CL-32/CL-32/CL32_296x120.bmp

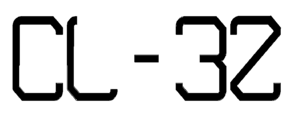
CL32_296x120.bmp
