CL-32/CL-32/Add-on/CL-32-LED/CL-32-LED.step

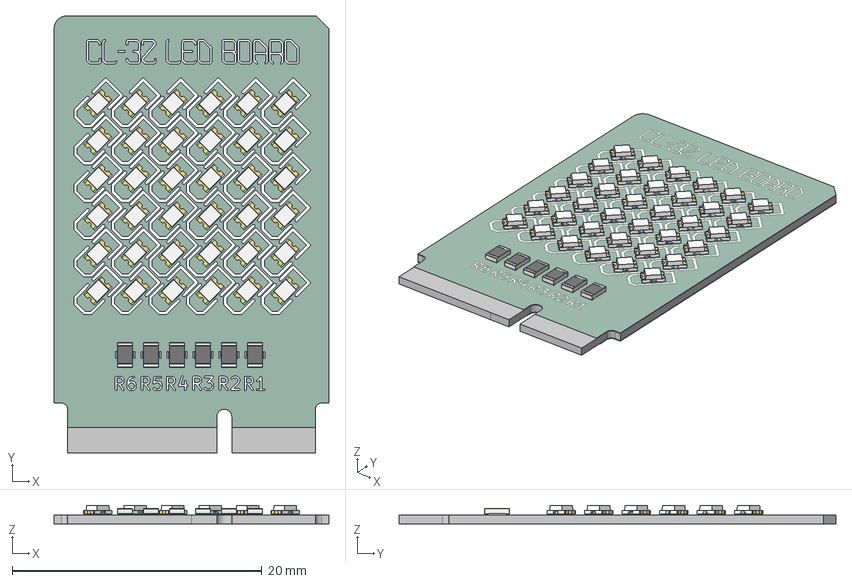
[picture p2: CAD file, 2025-10-23]
Add-on/CL-32-LED/CL-32-LED.step
22.0 x 35.0 x 1.55 mm
LED-SMD_L2.0-W1.3-H0.8 x 36
R_0805_2012Metric x 6
CL-32-LED_silkscreen
CL-32-LED_soldermask x 2
CL-32-LED_PCB
