CL-32/CL-32/PCB/Base Schematic.pdf

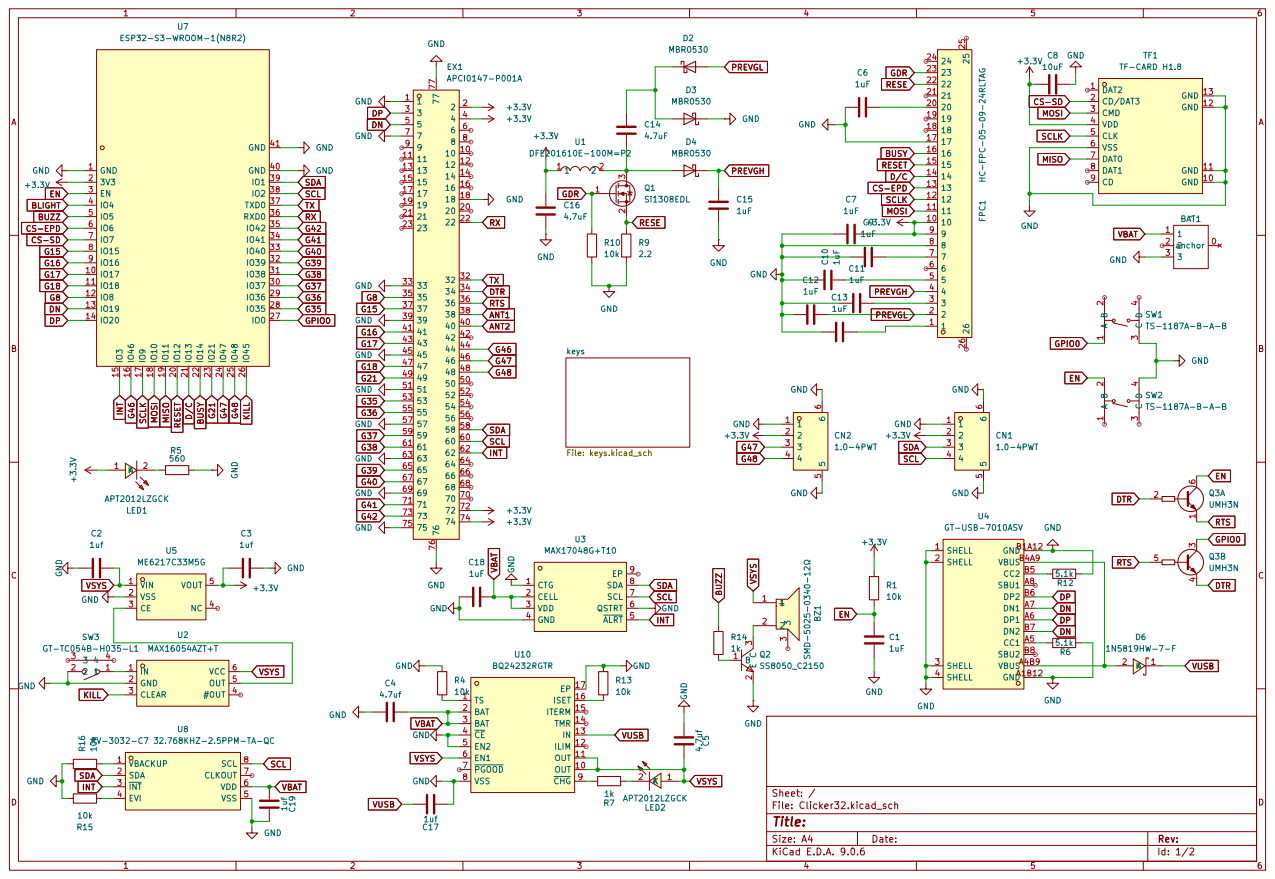
[picture p3: page 1]

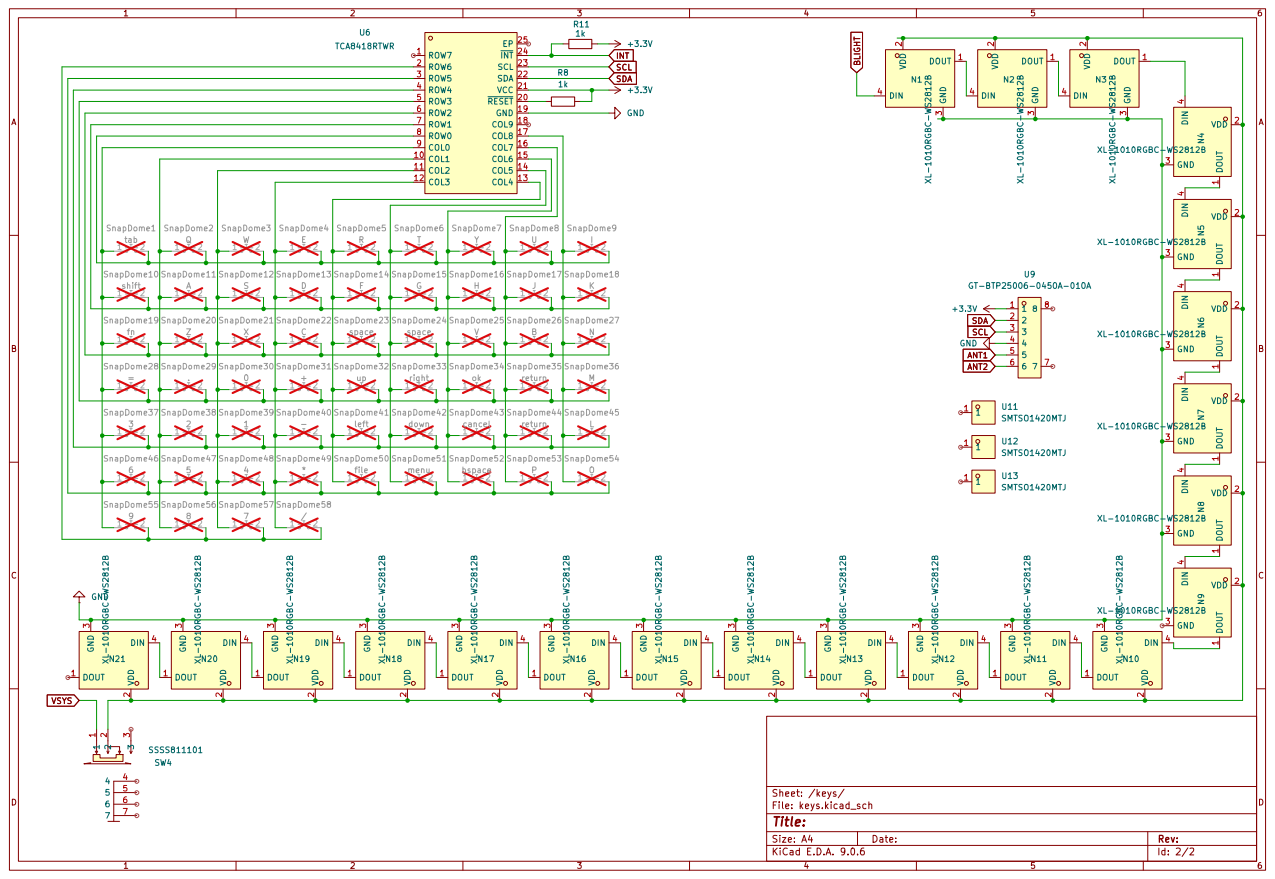
[picture p4: page 2]
