CL-32/CL-32/Add-on/CL-32-Cam/schematic.pdf

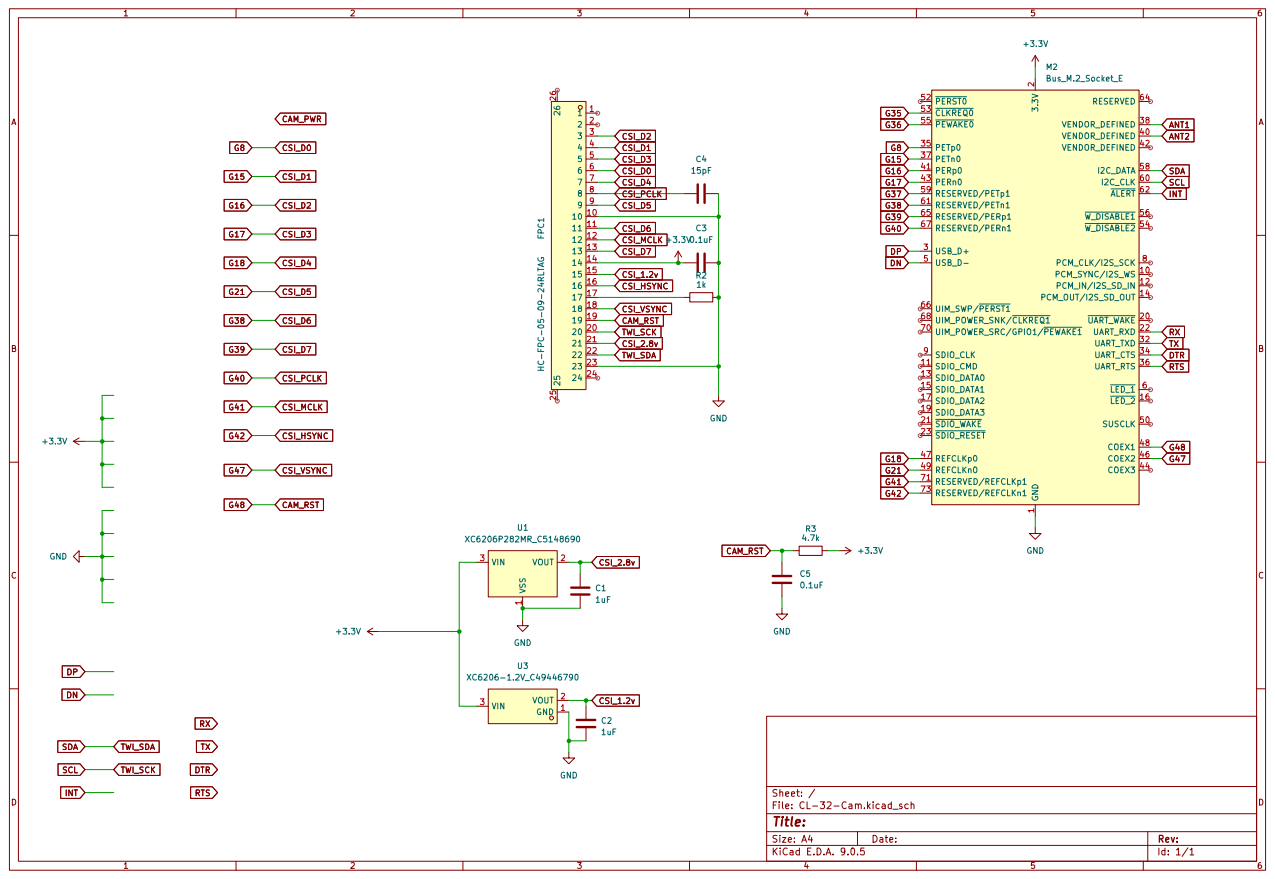
[picture p5: page 1]
