CL-32/CL-32/Add-on/CL-32-LED/schematic.pdf

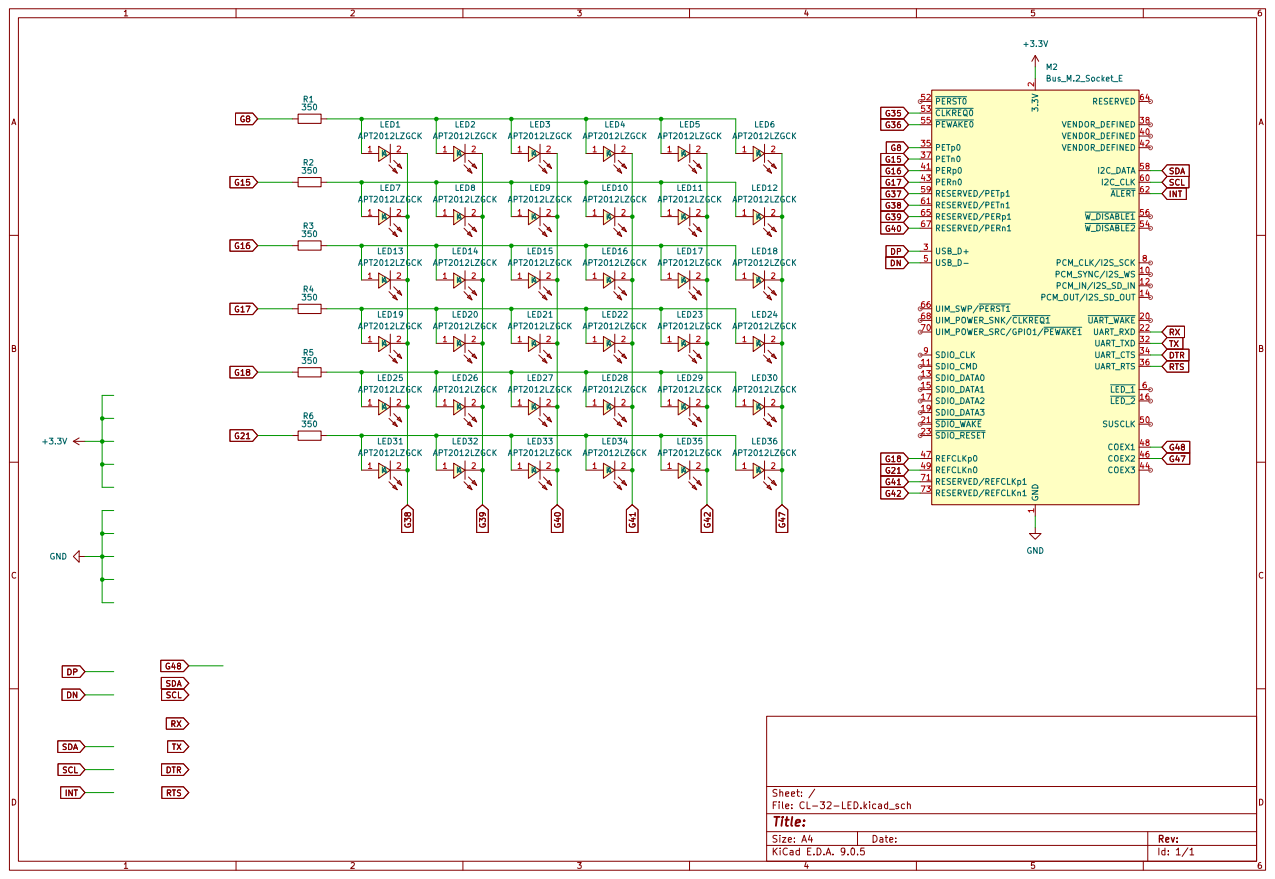
[picture p6: page 1]
