CL-32/CL-32/Add-on/CL-32-Mesh/schematic.pdf

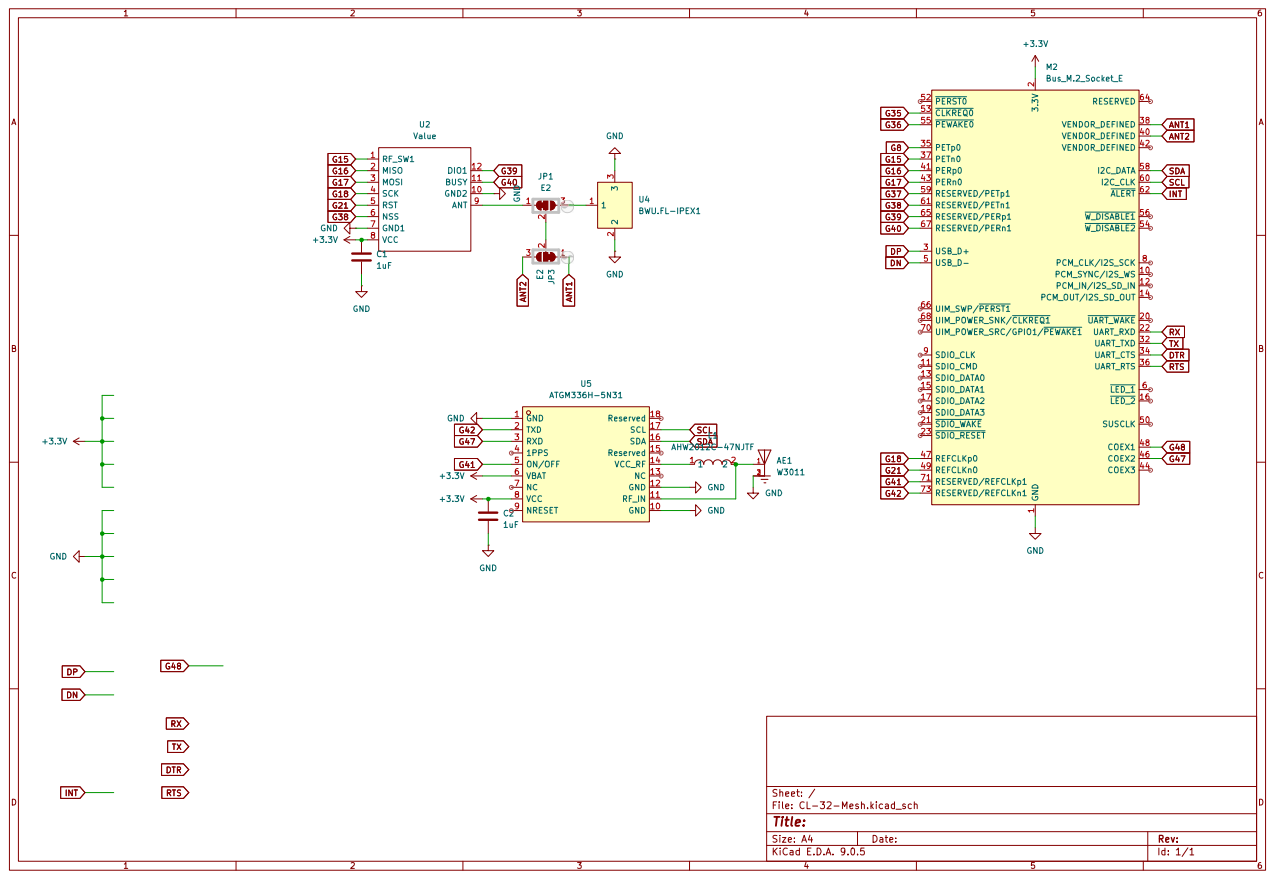
[picture p7: page 1]
