CL-32/CL-32/Software/CL-32/src/main.cpp

#include <Arduino.h>
#include "CL32.h"

int refreshCount;
volatile bool i2c_int = false;

void IRAM_ATTR letsGo(){
  i2c_int = true;
}

void setInterrupt(){
  //reset the correct interrupt after we have woken from sleep
  if(!blockSleep&&doSleep&&!_CL32.getUSB()){
    detachInterrupt(CL32_int);
    if (esp_sleep_enable_ext0_wakeup(GPIO_NUM_3, 0) != ESP_OK) {
        _screen.showMsg("GPIO interrupt failed");
    }
    if(refreshCount==0||(saverTime>0 && refreshCount>=saverTime)){//re-enable the timer
      if ( esp_sleep_enable_timer_wakeup(60000000) != ESP_OK) {
          _screen.showMsg("TIMER interrupt failed");
      }
    }
  }
  else {
    i2c_int = false;
    esp_sleep_disable_wakeup_source(ESP_SLEEP_WAKEUP_ALL);
    attachInterrupt(CL32_int ,letsGo, FALLING );
  }
}

void setup() {
    _screen.init();
    _CL32.init();
    _time.init();
    _CL32.add_callback(menu_keys);
    //Serial.begin(115200);
    draw_menu(fastAppSwitch);
    refreshCount = 0;
    doSleep=false;//force this false to get the start to be without sleep
    setInterrupt();
    load_set();//load the settings to probably put the sleep back
}

void loop() {
  if(i2c_int || esp_sleep_get_wakeup_cause()==ESP_SLEEP_WAKEUP_EXT0){
    //the interrupt is shared, so we need to see who is shouting
    _CL32.read();
    _time.read();
    refreshCount = 0;
    if(i2c_int) i2c_int = false;
    setInterrupt();
    if(!blockSleep&&doSleep&&!_CL32.getUSB()){
      esp_light_sleep_start();
    } 
  }
  else if(esp_sleep_get_wakeup_cause()==ESP_SLEEP_WAKEUP_TIMER){
    refreshCount++;
    if(saverTime>0 && refreshCount>=saverTime){
      _screen.drawSleep();
      esp_sleep_disable_wakeup_source(ESP_SLEEP_WAKEUP_TIMER);//stop the wakey wakey
    }
    else{
      _screen.refreshStatus();
    }
    esp_light_sleep_start(); //no need to check the variable here, this will only happen on timer wake which wont happen if sleep never happens
  }
}
