CL-32/CL-32/Software/CL-32/src/menu.cpp

#include <Arduino.h> 
#include "CL32.h"
//enum AppList {EDIT,CALC,TODO,CAL,AUTH,READ,SET};    
void change_app(bool increment){
    if(increment){
        switch (newApp) {
            case EDIT: newApp =  CALC; break;
            case CALC: newApp = TODO; break;
            case TODO: newApp =  CAL; break;
            case CAL: newApp =  AUTH; break;
            case AUTH: newApp =  READ; break;
            case READ: newApp =  SET; break;
            case SET: newApp = POWER; break;
            case POWER: newApp = EDIT;
        }
    }
    else{
        switch (newApp) {
            case EDIT: newApp =  POWER; break;
            case POWER: newApp =  SET; break;
            case CALC: newApp = EDIT; break;
            case TODO: newApp =  CALC; break;
            case CAL: newApp =  TODO; break;
            case AUTH: newApp =  CAL; break;
            case READ: newApp =  AUTH; break;
            case SET: newApp = READ;
        }
    }
}

//callback function for deciding what the menu does with the keyboard evenrs
void menu_keys(){
    for(byte i = _CL32.eventCount();i>0;i--){
        Event eTemp = _CL32.getKey();
        if(eTemp.keyDown){
            if(!eTemp.isChar){
                if(eTemp.keyData==KB_DOWN){
                    change_app(true);
                }
                else if(eTemp.keyData==KB_UP){
                    change_app(false);
                }
                else if(eTemp.keyData==KB_RET){
                    currentApp = newApp;
                    isMenu = OFF;//take it out of menu mode
                }
                else if(eTemp.keyData==KB_TAB){
                }
            }
            //dont really need an else here, if its not the 3 char's we aee interested in, then we dont neeed that key
        }
    }
    if(isMenu==OFF){        
        if(currentApp==EDIT){
            _CL32.add_callback(editor_keys);
            draw_editor(fastAppSwitch);
        }
        else if(currentApp==CALC){
            _CL32.add_callback(calc_keys);
            draw_calc(fastAppSwitch);
        }
        else if(currentApp==TODO){
            _CL32.add_callback(todo_keys);
            draw_todo(fastAppSwitch);
        }
        else if(currentApp==CAL){
            _CL32.add_callback(cal_keys);
            draw_cal(fastAppSwitch);
        }
        else if(currentApp==AUTH){
            _CL32.add_callback(twofa_keys);
            draw_twofa(fastAppSwitch);
        }
        else if(currentApp==READ){
            _CL32.add_callback(reader_keys);
            draw_reader(fastAppSwitch);
        }
        else if(currentApp==SET){
            _CL32.add_callback(set_keys);
            draw_set(fastAppSwitch);
        }
        else if(currentApp==POWER){
            _screen.clearScreen(false,true);
            _screen.showMsg("Powered Off");
            _CL32.shutdown();
        }
    }
    else{
        draw_menu(true);
    }
} 

//function for drawing the menu
void draw_menu(bool goFast){
    _screen.clearScreen(false,goFast);
    _screen.addHead("Menu");
    byte listOffset;
    if(newApp < 4){
        listOffset = 0;
    }
    else if(newApp > 4){
        listOffset = 1;
    }
    else{
        listOffset = newApp - 3;
    }
    for(byte i = 0;i<7;i++){
        if(i+listOffset==newApp){
            _screen.setFont(12,true,false);
        }
        else{
            _screen.setFont(12,false,false);
        }
        _screen.addText(appNames[i+listOffset],20,40+(i*20),true);
    }
    _screen.show(goFast);
}
