CL-32/CL-32/Software/CL-32/src/2fa.cpp

#include "CL32.h"
#include <Arduino.h> 


//callback function for deciding what to do with keyboard events
void twofa_keys(){
    for(byte i = _CL32.eventCount();i>0;i--){
        Event eTemp = _CL32.getKey();
        if(eTemp.keyDown){
            if(!eTemp.isChar){

            }
            else{

            }
        }
    }
    if(isMenu==ON){
        _CL32.add_callback(menu_keys);
        draw_menu(fastAppSwitch);
    }
    else{
        draw_twofa(true);
    }


}
//function for drawing the file browser screen
void draw_twofa(bool goFast){
    _screen.clearScreen(false,goFast);
    _screen.addHead("2FA Auth");

    //draw some stuff
    
    _screen.show(goFast);

}
