CL-32/CL-32/(commit log)

2025-10-14 refresh PCB
    removed EEPROM from the blank PCB, added back PCB incase anyone wants a play
2025-10-23 mesh board and LED board
    started populating the add-on boards so people can make their own
    [CL-32-LED.step]
2025-10-25 camera board
    camera board should be ready to play with
2025-11-22 more polish
    now does fast refresh between sections, menu button on the device now opens a sub menu (only in editor for now) there you can open a file, but the editor needs keyboard mapping
2025-11-23 file browser fix
    fixed some of the issues listing files, added some navigation on the editor
    [browser.cpp, editor.cpp]
2025-11-24 more tweakin
    got the battery monitoring involved, and some tweaks on editor navigation and editing
2025-11-25 more polishing
    added interupt read for RTC, and the space is there for the fuel gauge ic so you can clear any stray interrupts, re-jigged the get window code to better cope with page up/dn options, and added support in file browser for page up/dn too
2025-11-26 editor done??
    some more tweaking, you can now add/edit/delete text with no obvious bugs that i can see... on to the next thing
    [browser.cpp, editor.cpp]
2025-12-02 is it done??
    i think the editor is done, added a base framework for the calc, that can be copied all across the app board ready for more funsies :)
2025-12-16 calculated updates..
    made the calculator work, and might have got interrupts workging for non sleep, so we can inject keyboard events into running apps..
2025-12-28 merry christmas
    its been a while, preferences, todo lists, and firmware for both sides of the new test board :)
2026-08-11 voltz fix!!
    finally found the voltage reading issue!!!
2026-09-08 registry shuffle
    removed the raw keyboard status from the i2c register, and added a frontlight setting ready for release to future proof any systems that are starting to use CL-32
